tonidandel/scanner-linear/README.md

# scanner-linear
Repositório do projeto Scanner Linear de Livros, baseado em:
https://linearbookscanner.org/
