tonidandel/scanner-linear/projeto da Michigan-U/Wire_Diagram.pdf

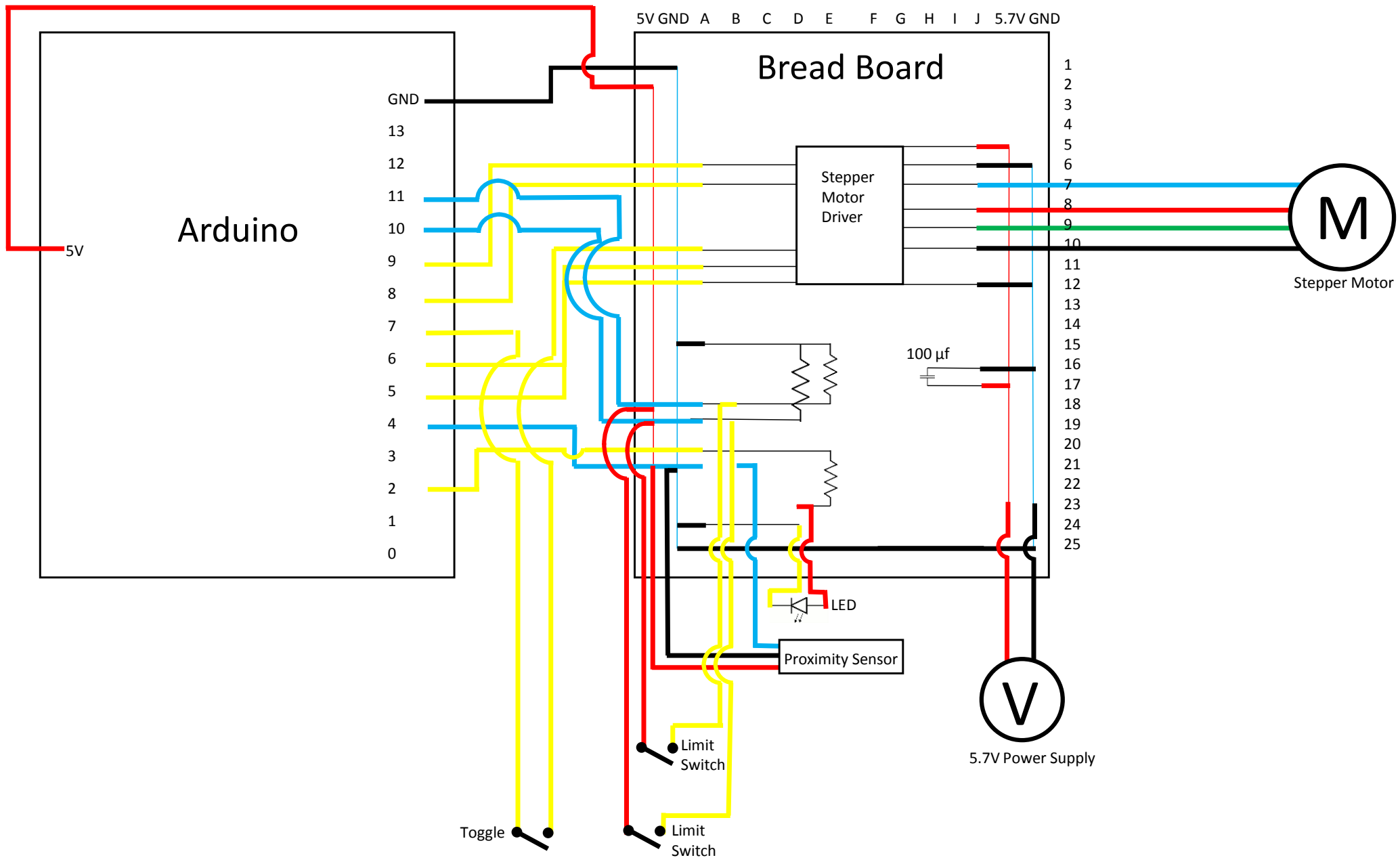
[picture p7: figure]
5V GND A; F G H I J 5.7V GND; GND; Arduino; Bread Board; 5.7V Power Supply; Proximity Sensor v; LED; Stepper Motor; Limit Switch; Toggle; Stepper Motor Driver
