tonidandel/scanner-linear/projeto da Michigan-U/LinearBookScannerCADW14/Follower Pulley Mounts/Follower Pulley Assembly.SLDASM

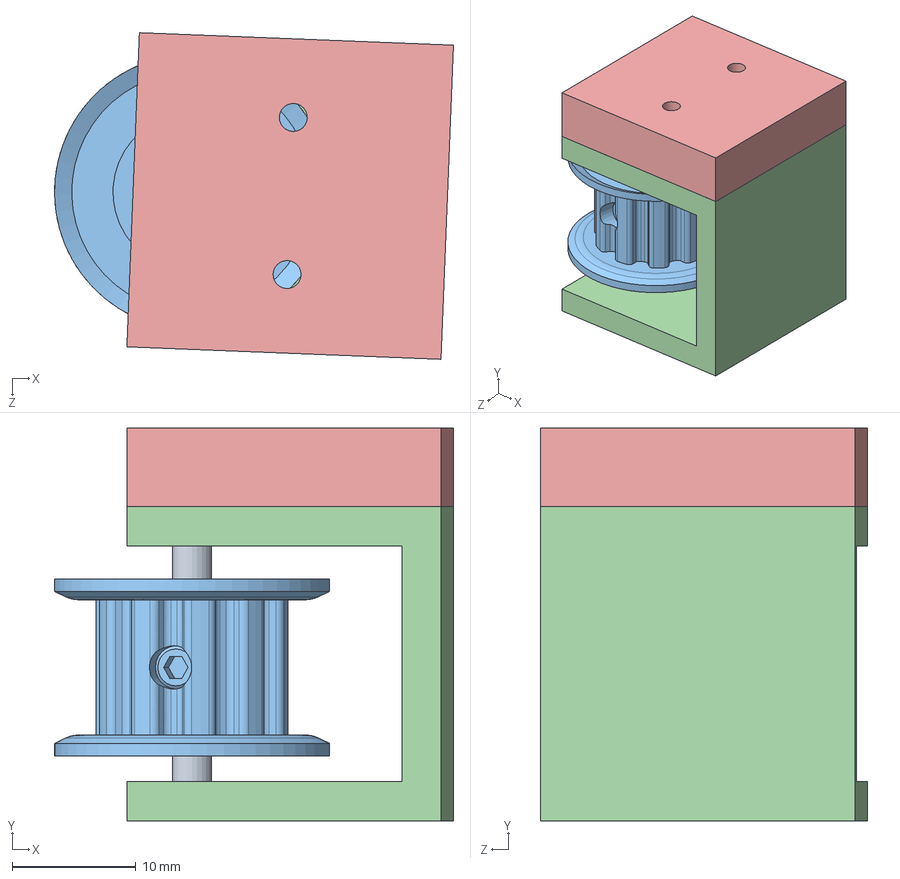
[picture p8: CAD file, 2019-04-22]
projeto da Michigan-U/LinearBookScannerCADW14/Follower Pulley Mounts/Follower Pulley Assembly.SLDASM
32.2 x 31.8 x 26.4 mm
Follower Pulley Shaft
Bushing
Follower Pulley
Follower Pulley Mount
Follower Spacer
