tonidandel/scanner-linear/projeto da Michigan-U/LinearBookScannerCADW14/Main Body/Linear Book Scanner.SLDASM

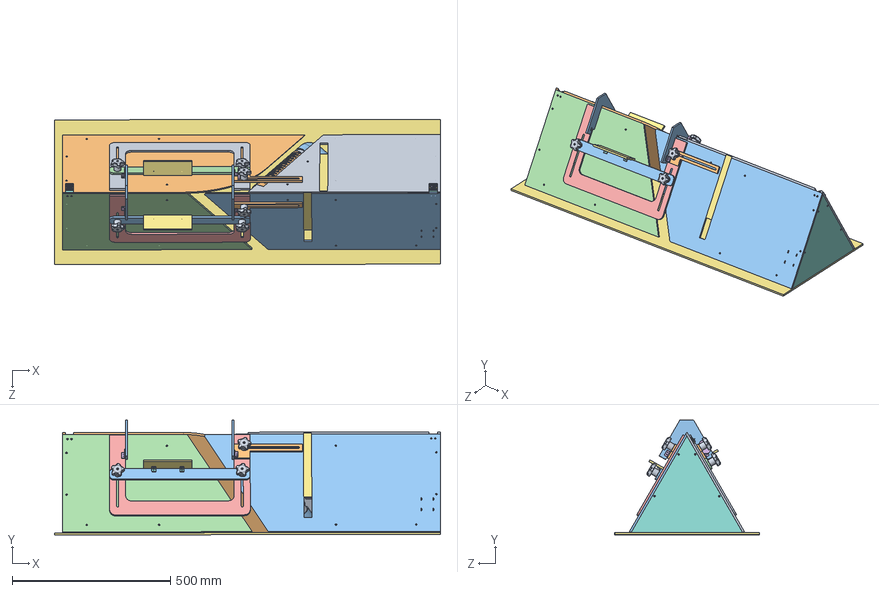
[picture p9: CAD file, 2019-04-22]
projeto da Michigan-U/LinearBookScannerCADW14/Main Body/Linear Book Scanner.SLDASM
1219.6 x 363.2 x 458.2 mm
Wall_1a
Wall_1b
Wall_2a
Wall_2b
90degBracket x 18
Brace_short x 4
Driven Pulley
Stepper Motor
Coupler
Bearing x 2
Motor Mount
Follower Pulley Shaft x 3
Bushing x 3
Follower Pulley x 3
Follower Pulley Mount x 3
Follower Spacer x 3
Inside Vacuum Tube
Outside Vacuum Tube
Elbow
Vacuum Plug
60degBracket x 8
Canon+220+Scanner+Bar x 2
GLASS+COVER%2C+SCANNER+BAR x 2
Bracket Vacuum Tube x 2
Side Intake
X Paddle Left Attachment
X Paddle Left 60 x 2
Cross Bar
Side Intake Back
X Paddle Bracket x 2
Y Paddle x 2
Standard Bracket x 4
59625K330 (1) x 6
X Paddle Left Attachment Back
Cross Bar Back
92210A546 x 6
91500A126 x 4
Tall X Paddle Bracket x 2
Base
Brace x 2
