tonidandel/scanner-linear/projeto da Michigan-U/LinearBookScannerCADW14/Vacuum/Vacuum Tube Assembly.SLDASM

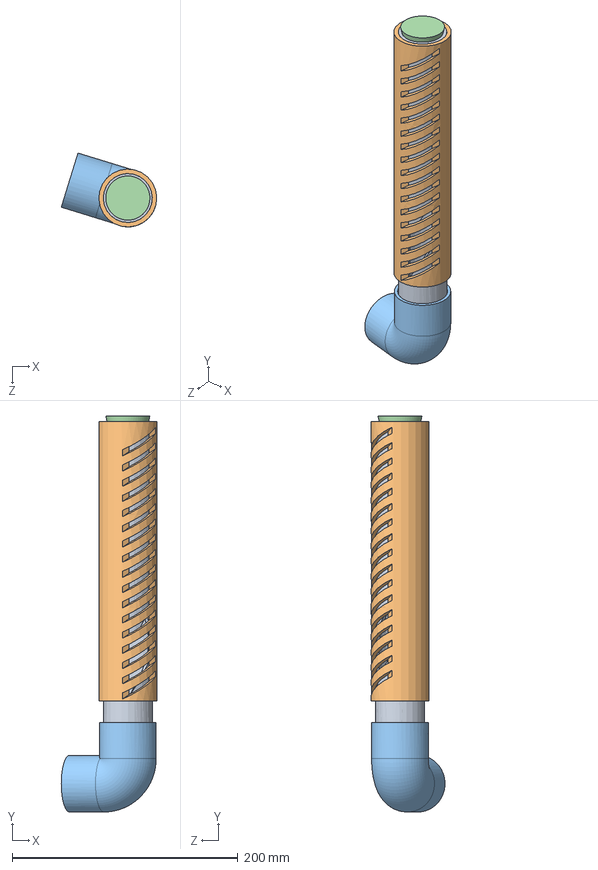
[picture p10: CAD file, 2019-04-22]
projeto da Michigan-U/LinearBookScannerCADW14/Vacuum/Vacuum Tube Assembly.SLDASM
84.6 x 350.9 x 65.5 mm
Inside Vacuum Tube
Outside Vacuum Tube
Elbow
Vacuum Plug
