tonidandel/scanner-linear/projeto da Michigan-U/LinearBookScannerCADW14/Scanner Bar/Scanner.SLDASM

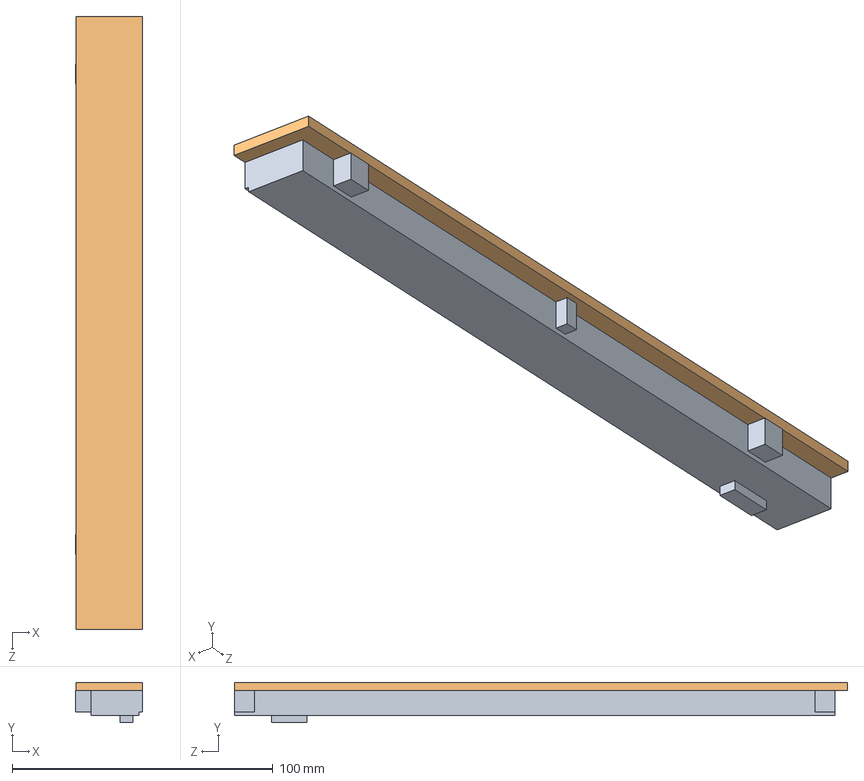
[picture p11: CAD file, 2019-04-22]
projeto da Michigan-U/LinearBookScannerCADW14/Scanner Bar/Scanner.SLDASM
25.5 x 15.5 x 235.0 mm
Canon+220+Scanner+Bar
GLASS+COVER%2C+SCANNER+BAR
