tonidandel/scanner-linear/projeto da Michigan-U/LinearBookScannerCADW14/Main Body/Large Brace Assm.SLDASM

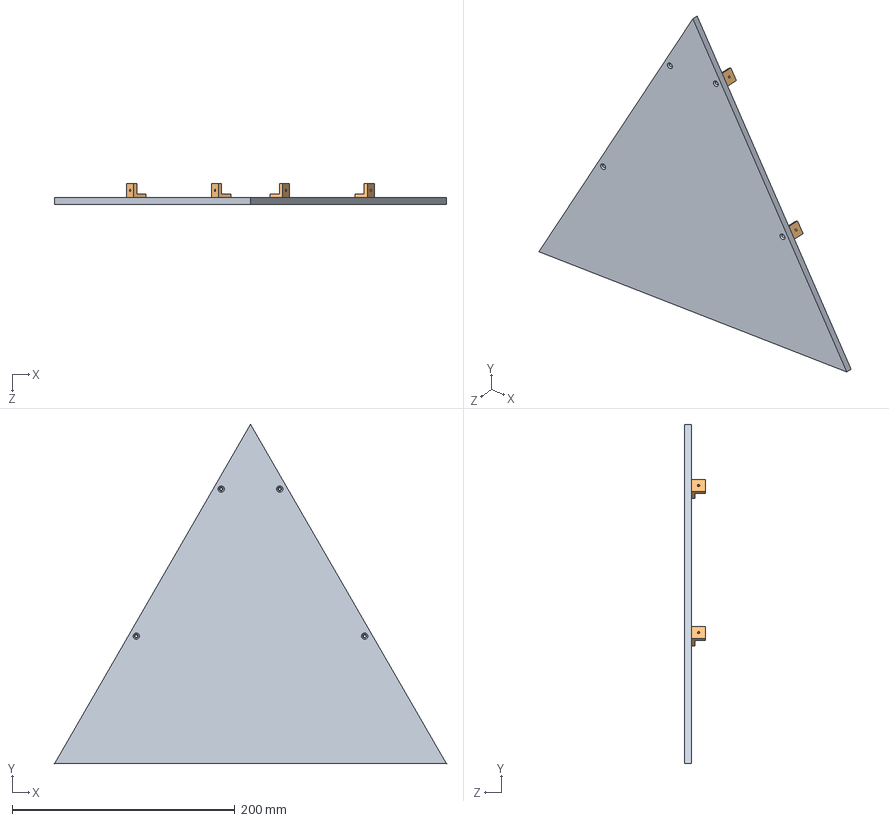
[picture p12: CAD file, 2019-04-22]
projeto da Michigan-U/LinearBookScannerCADW14/Main Body/Large Brace Assm.SLDASM
351.8 x 304.7 x 19.0 mm
Brace
90degBracket x 4
