tonidandel/scanner-linear/projeto da Michigan-U/LinearBookScannerCADW14/Vacuum/Vacuum Tube Bracket.SLDASM

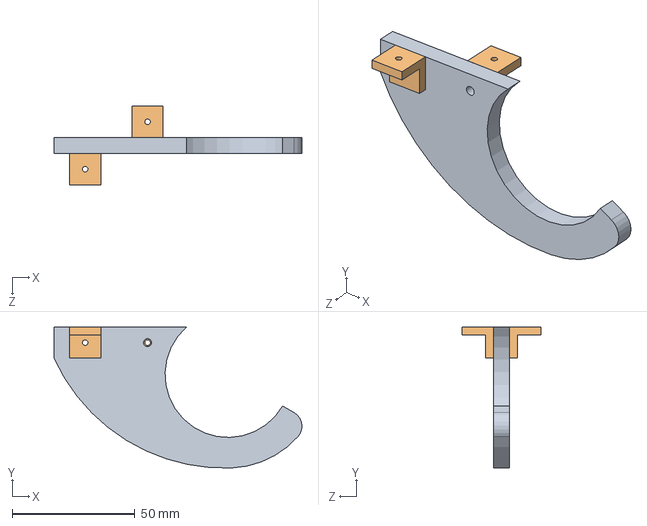
[picture p13: CAD file, 2019-04-22]
projeto da Michigan-U/LinearBookScannerCADW14/Vacuum/Vacuum Tube Bracket.SLDASM
101.0 x 57.4 x 32.0 mm
Bracket Vacuum Tube
90degBracket x 2
