tonidandel/scanner-linear/projeto da Michigan-U/LinearBookScannerCADW14/Main Body/Brace.SLDASM

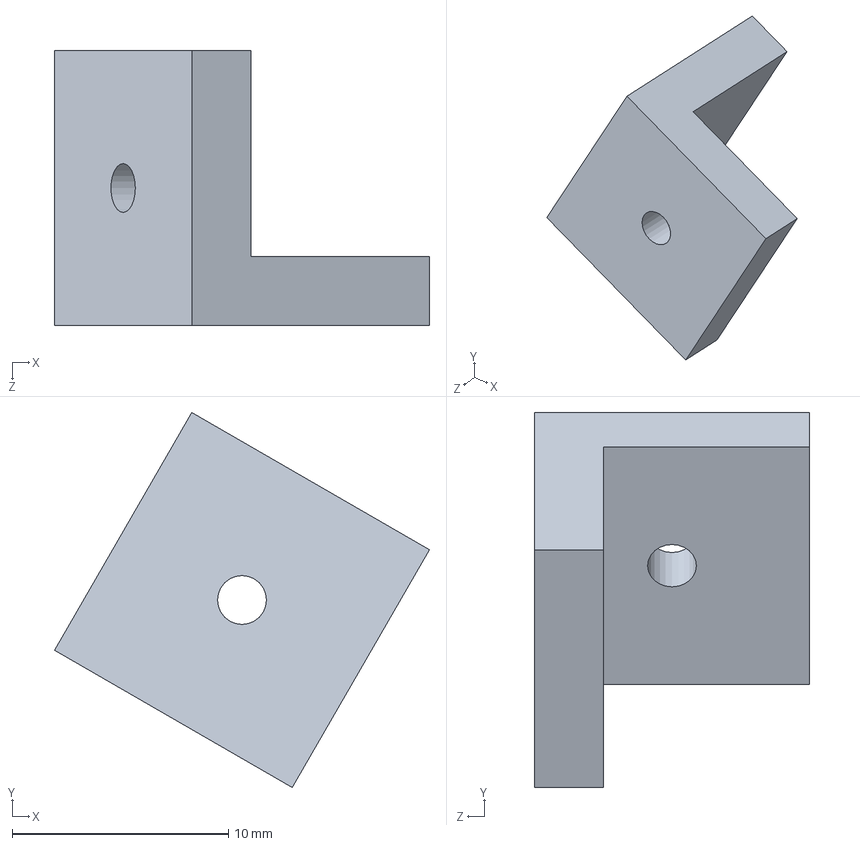
[picture p14: CAD file, 2019-04-22]
projeto da Michigan-U/LinearBookScannerCADW14/Main Body/Brace.SLDASM
17.3 x 17.3 x 12.7 mm
