tonidandel/scanner-linear/projeto da Michigan-U/LinearBookScannerCADW14/Motor/Motor Assembly v1/Motor Mount Assembly.SLDASM

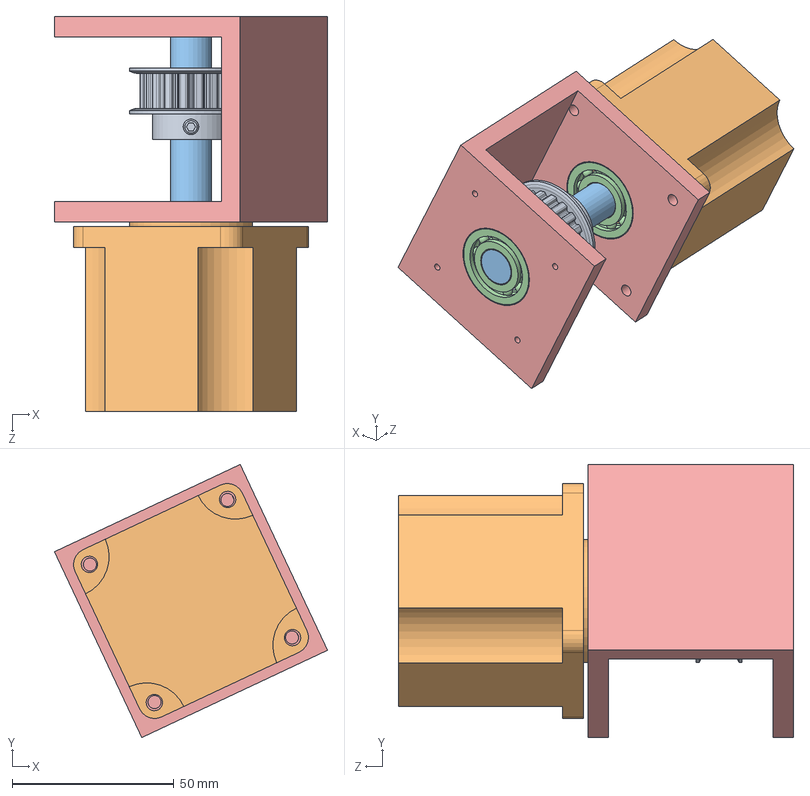
[picture p15: CAD file, 2019-04-22]
projeto da Michigan-U/LinearBookScannerCADW14/Motor/Motor Assembly v1/Motor Mount Assembly.SLDASM
84.5 x 84.5 x 122.2 mm
Driven Pulley
Stepper Motor
Coupler
Bearing x 2
Motor Mount
