tonidandel/scanner-linear/projeto da Michigan-U/LinearBookScannerCADW14/Saddle CAD v2/New Saddle CAD/Saddle Assembly.SLDASM

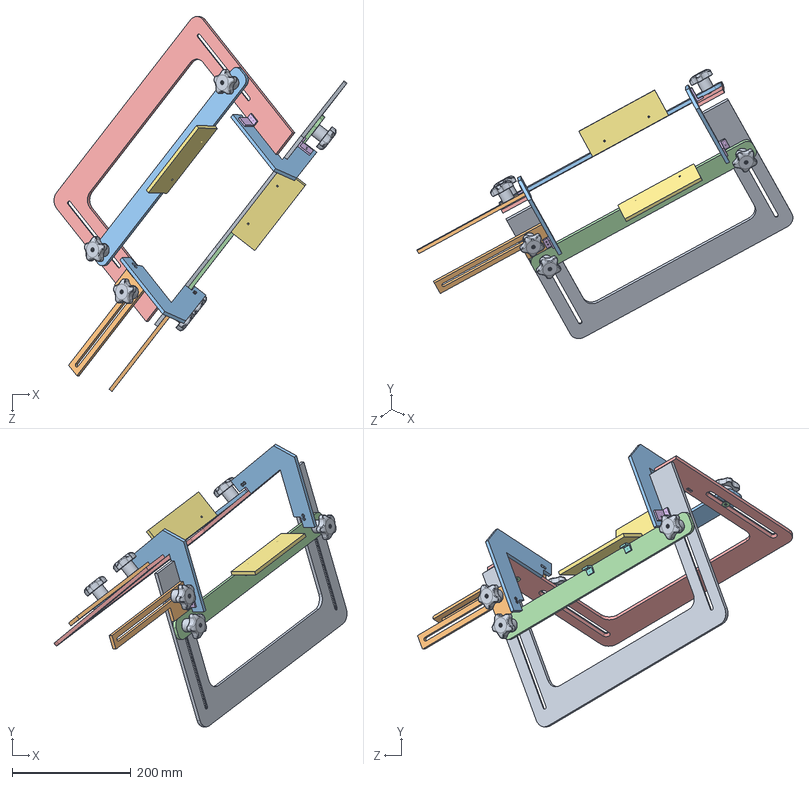
[picture p16: CAD file, 2019-04-22]
projeto da Michigan-U/LinearBookScannerCADW14/Saddle CAD v2/New Saddle CAD/Saddle Assembly.SLDASM
494.0 x 476.6 x 632.3 mm
Side Intake
X Paddle Left Attachment
X Paddle Left 60 x 2
Cross Bar
Side Intake Back
X Paddle Bracket x 2
Y Paddle x 2
Standard Bracket x 4
59625K330 (1) x 6
X Paddle Left Attachment Back
Cross Bar Back
92210A546 x 6
91500A126 x 4
Tall X Paddle Bracket x 2
