tonidandel/scanner-linear/projeto da Michigan-U/LinearBookScannerCADW14/Motor/Motor Assembly v1/Stepper Motor.SLDPRT

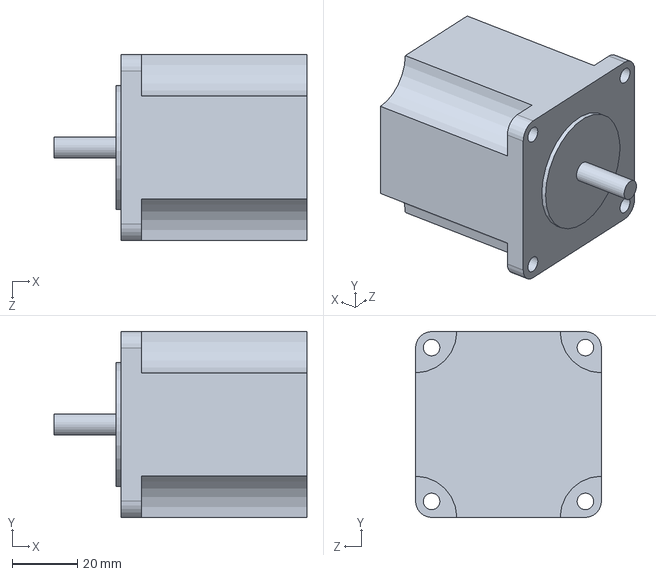
[picture p17: CAD file, 2019-04-22]
projeto da Michigan-U/LinearBookScannerCADW14/Motor/Motor Assembly v1/Stepper Motor.SLDPRT
77.7 x 57.1 x 57.1 mm
