tonidandel/scanner-linear/projeto da Michigan-U/LinearBookScannerCADW14/Saddle CAD v2/New Saddle CAD/Side Intake Back.SLDPRT

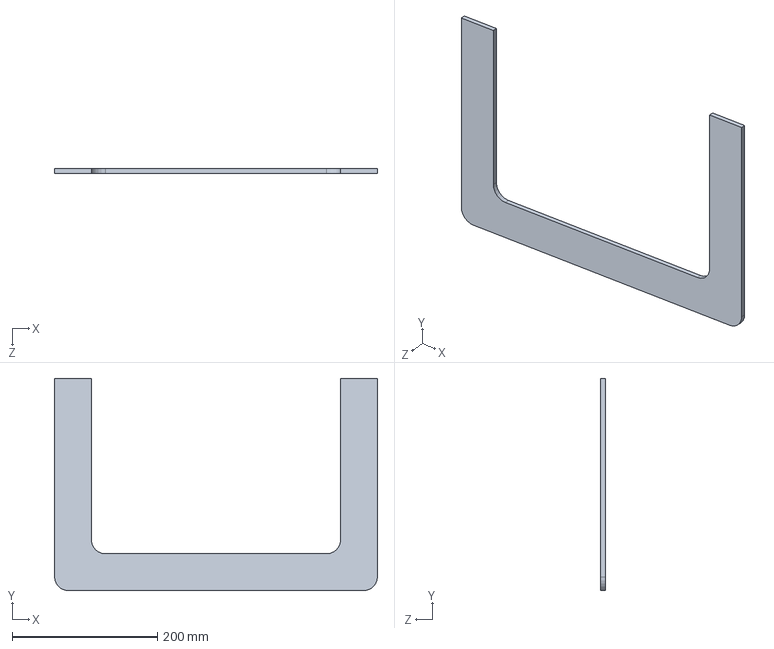
[picture p18: CAD file, 2019-04-22]
projeto da Michigan-U/LinearBookScannerCADW14/Saddle CAD v2/New Saddle CAD/Side Intake Back.SLDPRT
444.5 x 292.1 x 6.35 mm
