tonidandel/scanner-linear/projeto da Michigan-U/LinearBookScannerCADW14/Scanner Bar/GLASS+COVER%2C+SCANNER+BAR.SLDPRT

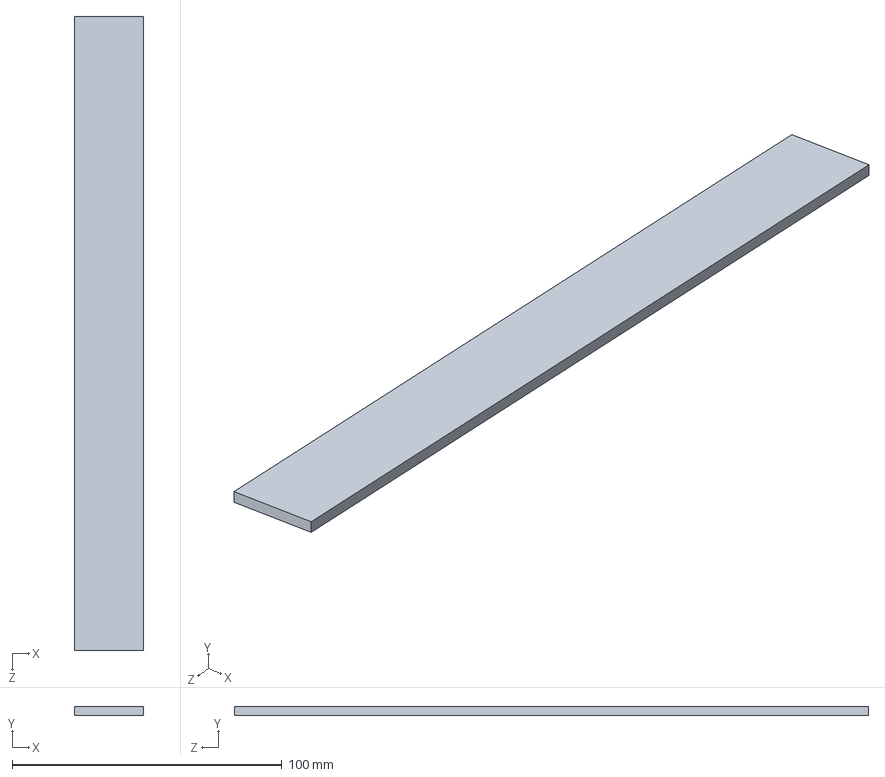
[picture p19: CAD file, 2019-04-22]
projeto da Michigan-U/LinearBookScannerCADW14/Scanner Bar/GLASS+COVER%2C+SCANNER+BAR.SLDPRT
25.4 x 3.17 x 235.0 mm
