tonidandel/scanner-linear/projeto da Michigan-U/LinearBookScannerCADW14/Follower Pulley Mounts/Bushing.SLDPRT

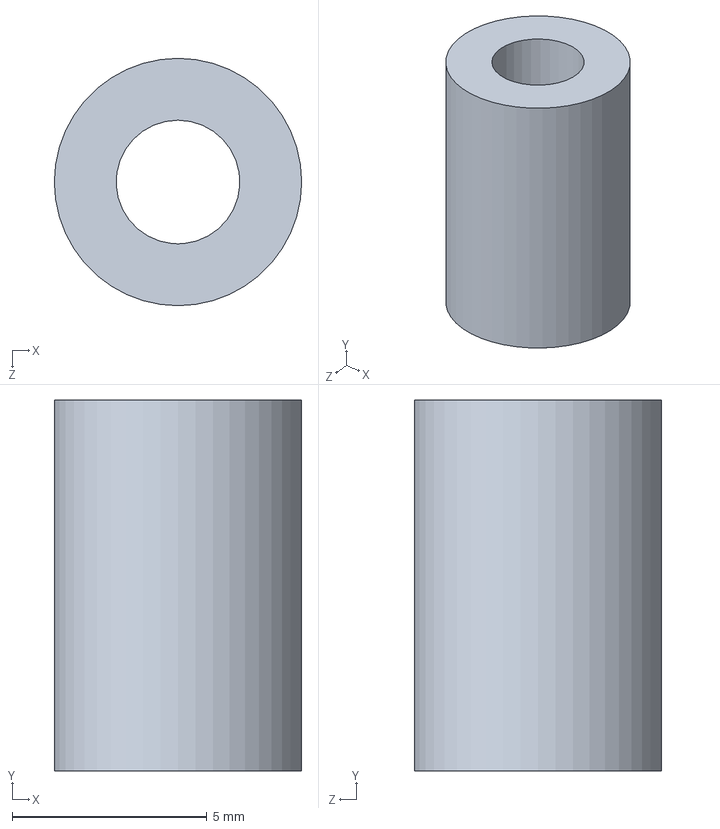
[picture p20: CAD file, 2019-04-22]
projeto da Michigan-U/LinearBookScannerCADW14/Follower Pulley Mounts/Bushing.SLDPRT
6.35 x 9.53 x 6.35 mm
