tonidandel/scanner-linear/projeto da Michigan-U/LinearBookScannerCADW14/Main Body/90degBracket.SLDPRT

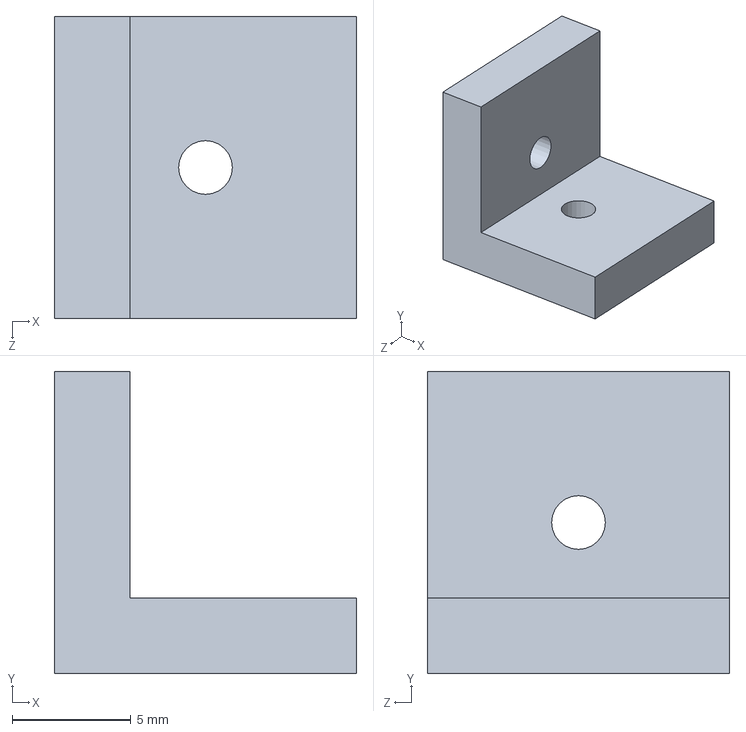
[picture p21: CAD file, 2019-04-22]
projeto da Michigan-U/LinearBookScannerCADW14/Main Body/90degBracket.SLDPRT
12.7 x 12.7 x 12.7 mm
