tonidandel/scanner-linear/projeto da Michigan-U/LinearBookScannerCADW14/Motor/Motor Assembly v1/Coupler.SLDPRT

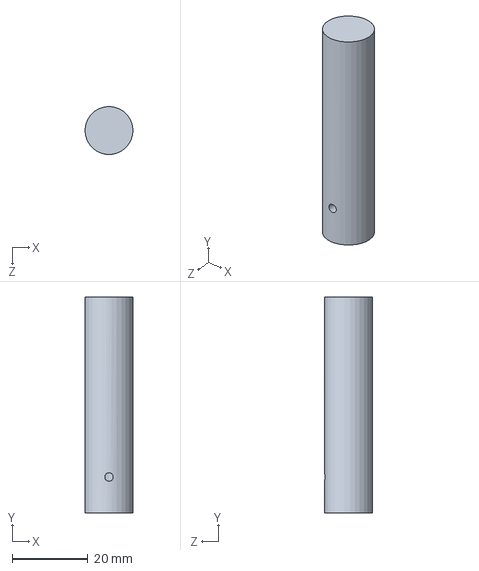
[picture p22: CAD file, 2019-04-22]
projeto da Michigan-U/LinearBookScannerCADW14/Motor/Motor Assembly v1/Coupler.SLDPRT
12.7 x 57.1 x 12.7 mm
