tonidandel/scanner-linear/projeto da Michigan-U/LinearBookScannerCADW14/Saddle CAD v2/New Saddle CAD/X Paddle Bracket.SLDPRT

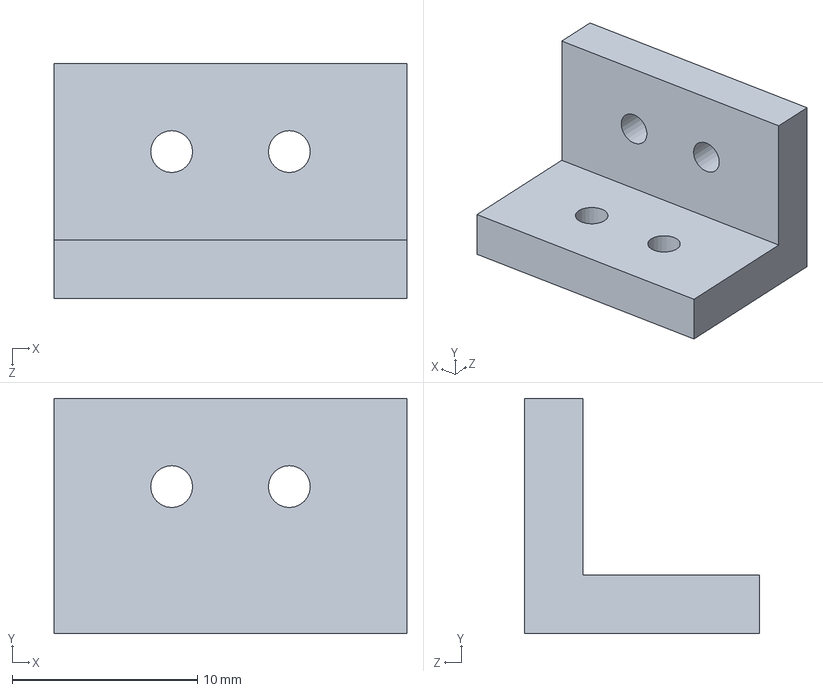
[picture p23: CAD file, 2019-04-22]
projeto da Michigan-U/LinearBookScannerCADW14/Saddle CAD v2/New Saddle CAD/X Paddle Bracket.SLDPRT
19.1 x 12.7 x 12.7 mm
