tonidandel/scanner-linear/projeto da Michigan-U/LinearBookScannerCADW14/Vacuum/Elbow.SLDPRT

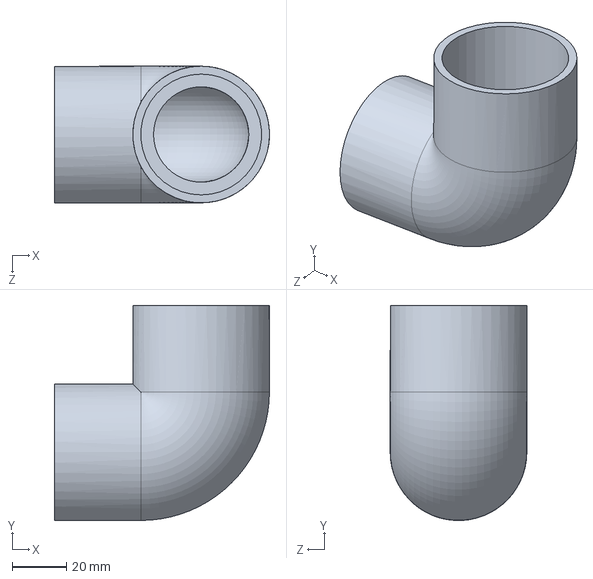
[picture p24: CAD file, 2019-04-22]
projeto da Michigan-U/LinearBookScannerCADW14/Vacuum/Elbow.SLDPRT
79.1 x 79.1 x 50.3 mm
