tonidandel/scanner-linear/projeto da Michigan-U/LinearBookScannerCADW14/Follower Pulley Mounts/Follower Pulley.SLDPRT

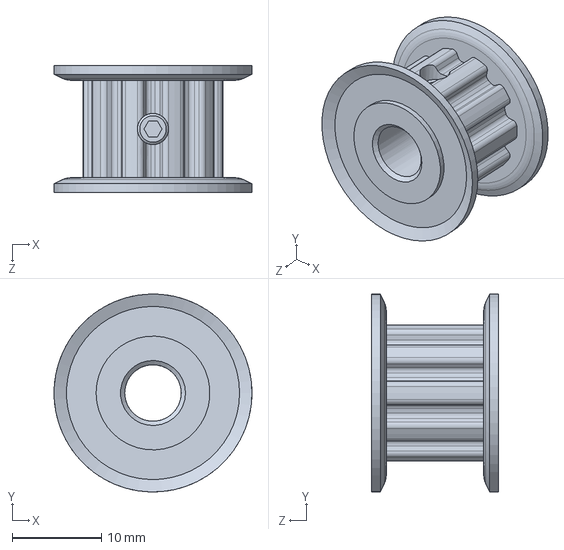
[picture p25: CAD file, 2019-04-22]
projeto da Michigan-U/LinearBookScannerCADW14/Follower Pulley Mounts/Follower Pulley.SLDPRT
22.2 x 22.2 x 14.3 mm
