tonidandel/scanner-linear/projeto da Michigan-U/LinearBookScannerCADW14/Main Body/Brace_short.SLDPRT

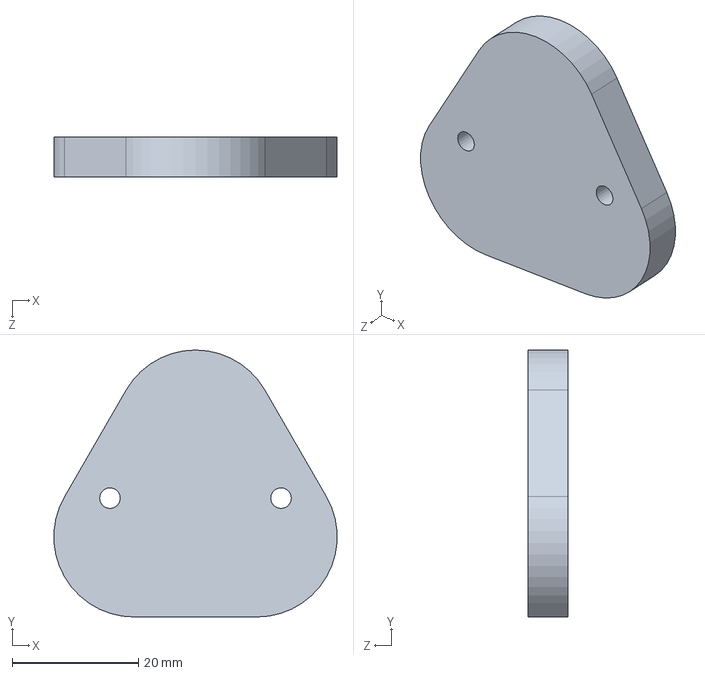
[picture p26: CAD file, 2019-04-22]
projeto da Michigan-U/LinearBookScannerCADW14/Main Body/Brace_short.SLDPRT
44.8 x 42.3 x 6.35 mm
