tonidandel/scanner-linear/projeto da Michigan-U/LinearBookScannerCADW14/Motor/Motor Assembly v1/Driven Pulley.SLDPRT

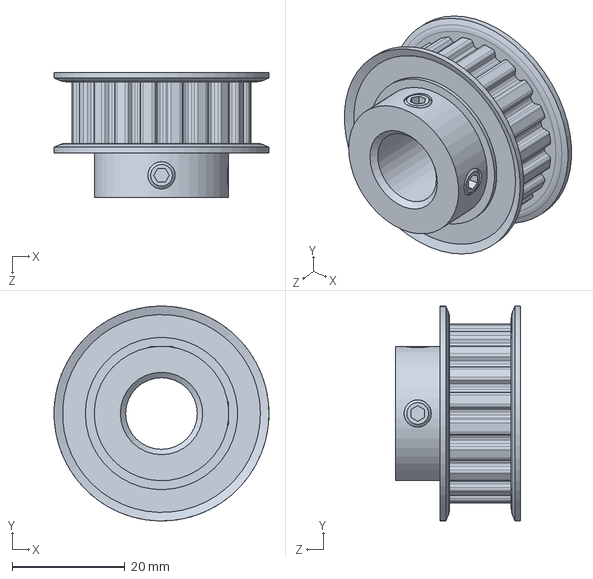
[picture p27: CAD file, 2019-04-22]
projeto da Michigan-U/LinearBookScannerCADW14/Motor/Motor Assembly v1/Driven Pulley.SLDPRT
38.1 x 38.1 x 22.2 mm
