tonidandel/scanner-linear/projeto da Michigan-U/LinearBookScannerCADW14/Saddle CAD v2/New Saddle CAD/Y Paddle.SLDPRT

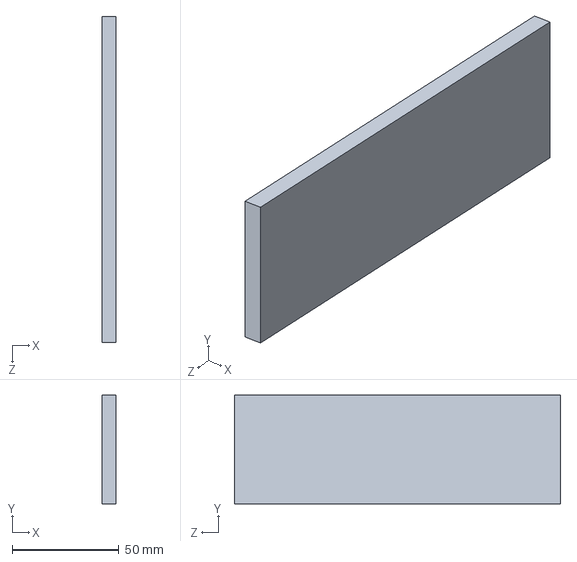
[picture p28: CAD file, 2019-04-22]
projeto da Michigan-U/LinearBookScannerCADW14/Saddle CAD v2/New Saddle CAD/Y Paddle.SLDPRT
6.35 x 50.8 x 152.4 mm
