tonidandel/scanner-linear/projeto da Michigan-U/LinearBookScannerCADW14/Scanner Bar/Canon+220+Scanner+Bar.SLDPRT

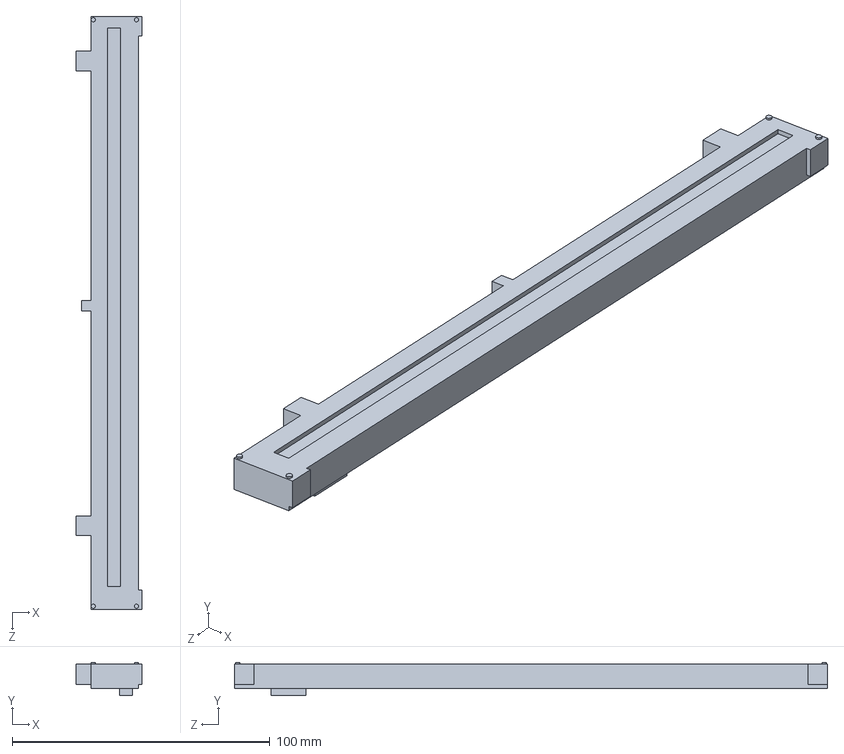
[picture p29: CAD file, 2019-04-22]
projeto da Michigan-U/LinearBookScannerCADW14/Scanner Bar/Canon+220+Scanner+Bar.SLDPRT
25.5 x 12.8 x 230.2 mm
