tonidandel/scanner-linear/projeto da Michigan-U/LinearBookScannerCADW14/Vacuum/Outside Vacuum Tube.SLDPRT

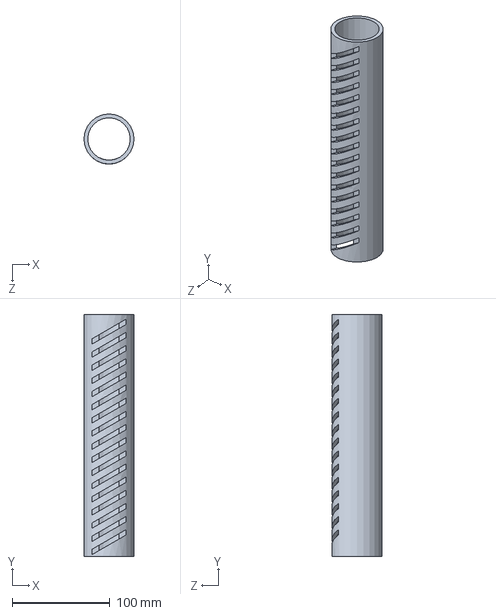
[picture p30: CAD file, 2019-04-22]
projeto da Michigan-U/LinearBookScannerCADW14/Vacuum/Outside Vacuum Tube.SLDPRT
51.3 x 247.6 x 51.3 mm
