tonidandel/scanner-linear/projeto da Michigan-U/LinearBookScannerCADW14/Follower Pulley Mounts/Follower Pulley Shaft.SLDPRT

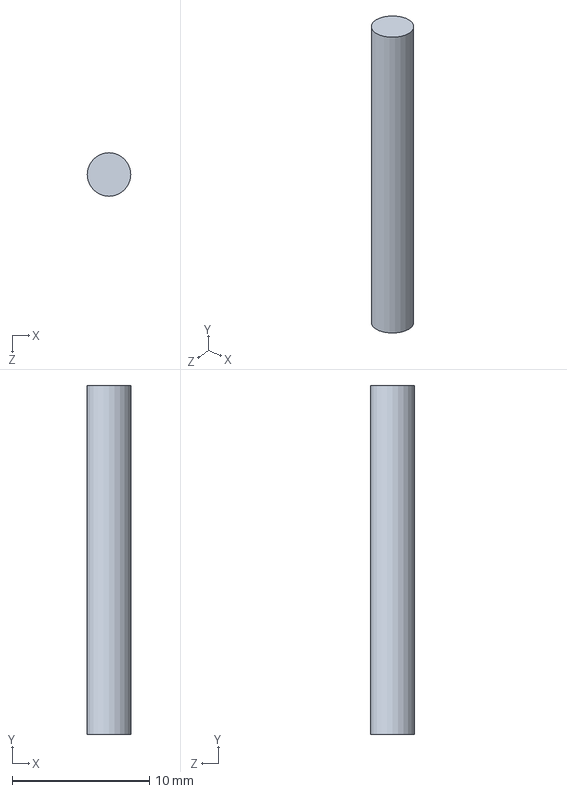
[picture p31: CAD file, 2019-04-22]
projeto da Michigan-U/LinearBookScannerCADW14/Follower Pulley Mounts/Follower Pulley Shaft.SLDPRT
3.17 x 25.4 x 3.17 mm
