tonidandel/scanner-linear/projeto da Michigan-U/LinearBookScannerCADW14/Motor/Motor Assembly v1/Motor Mount.SLDPRT

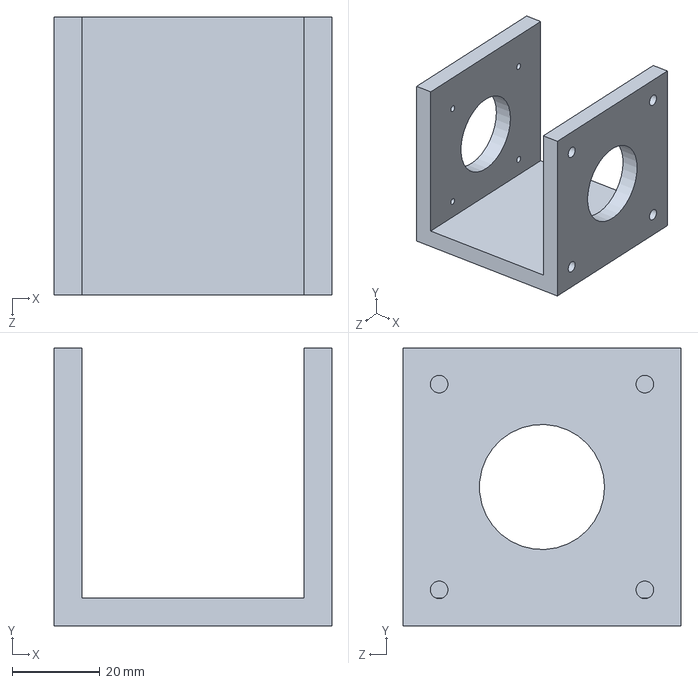
[picture p32: CAD file, 2019-04-22]
projeto da Michigan-U/LinearBookScannerCADW14/Motor/Motor Assembly v1/Motor Mount.SLDPRT
63.5 x 63.5 x 63.5 mm
