tonidandel/scanner-linear/projeto da Michigan-U/LinearBookScannerCADW14/Saddle CAD v2/New Saddle CAD/Top Angle Bracket.SLDPRT

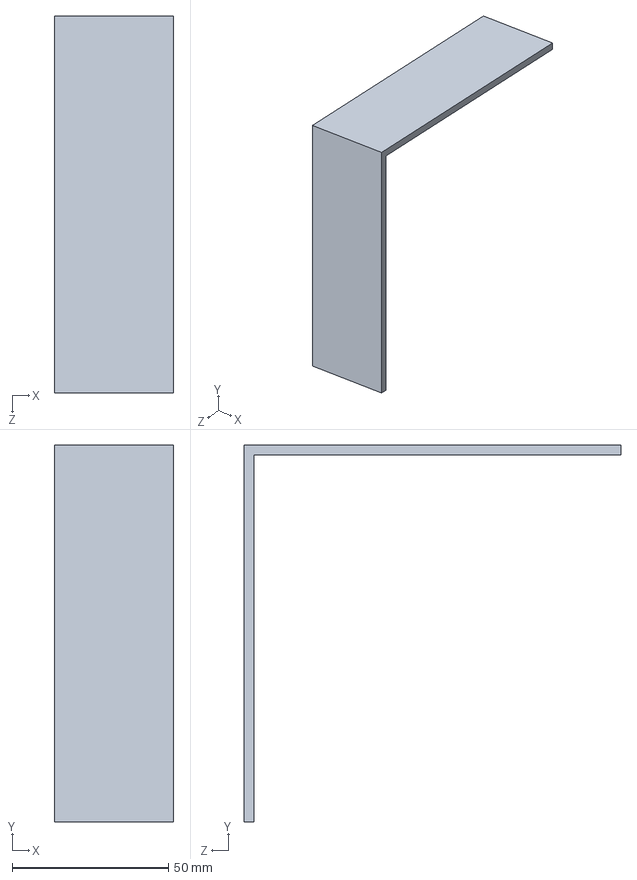
[picture p33: CAD file, 2019-04-22]
projeto da Michigan-U/LinearBookScannerCADW14/Saddle CAD v2/New Saddle CAD/Top Angle Bracket.SLDPRT
38.1 x 120.7 x 120.7 mm
