tonidandel/scanner-linear/projeto da Michigan-U/LinearBookScannerCADW14/Vacuum/Inside Vacuum Tube.SLDPRT

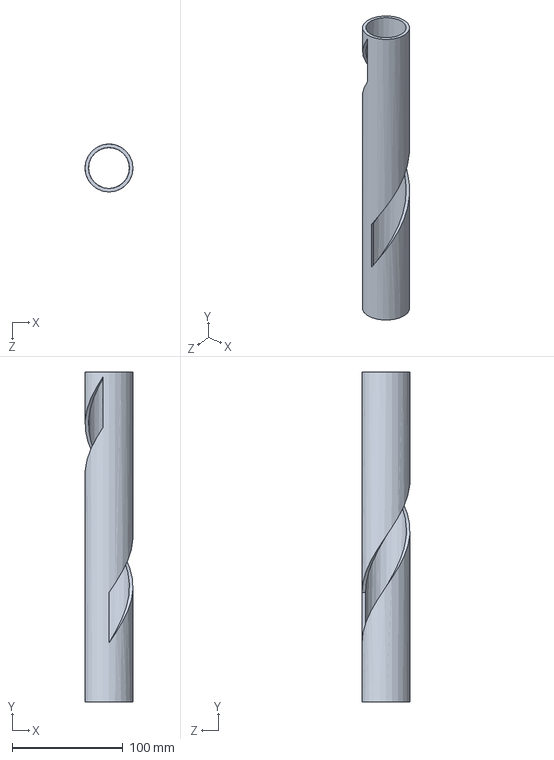
[picture p34: CAD file, 2019-04-22]
projeto da Michigan-U/LinearBookScannerCADW14/Vacuum/Inside Vacuum Tube.SLDPRT
43.4 x 298.5 x 43.4 mm
