tonidandel/scanner-linear/projeto da Michigan-U/LinearBookScannerCADW14/Follower Pulley Mounts/Follower Spacer.SLDPRT

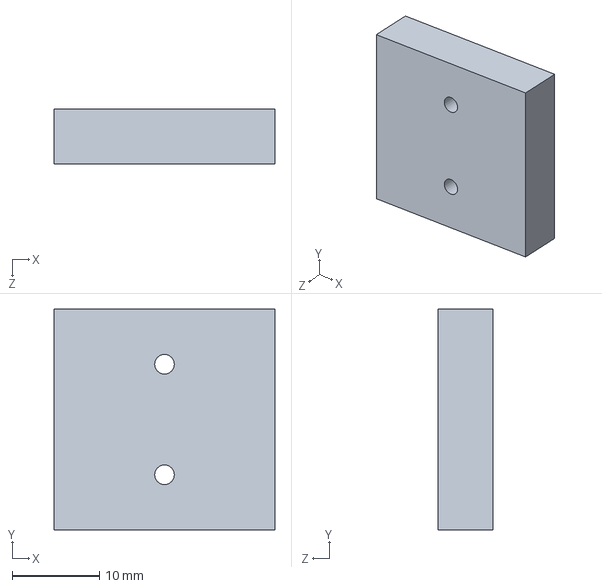
[picture p35: CAD file, 2019-04-22]
projeto da Michigan-U/LinearBookScannerCADW14/Follower Pulley Mounts/Follower Spacer.SLDPRT
25.4 x 25.4 x 6.35 mm
