tonidandel/scanner-linear/projeto da Michigan-U/LinearBookScannerCADW14/Main Body/Base.SLDPRT

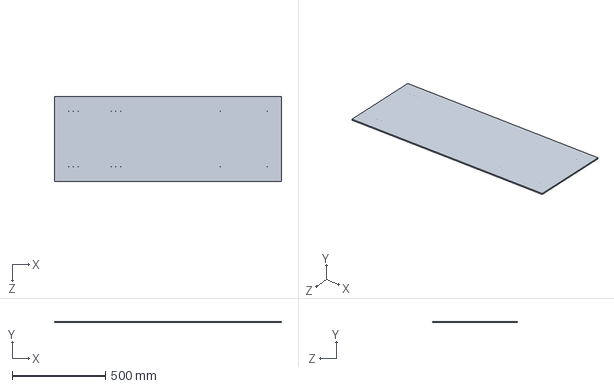
[picture p36: CAD file, 2019-04-22]
projeto da Michigan-U/LinearBookScannerCADW14/Main Body/Base.SLDPRT
1219.2 x 6.35 x 457.2 mm
