tonidandel/scanner-linear/projeto da Michigan-U/LinearBookScannerCADW14/Motor/Motor Assembly v1/Bearing.SLDPRT

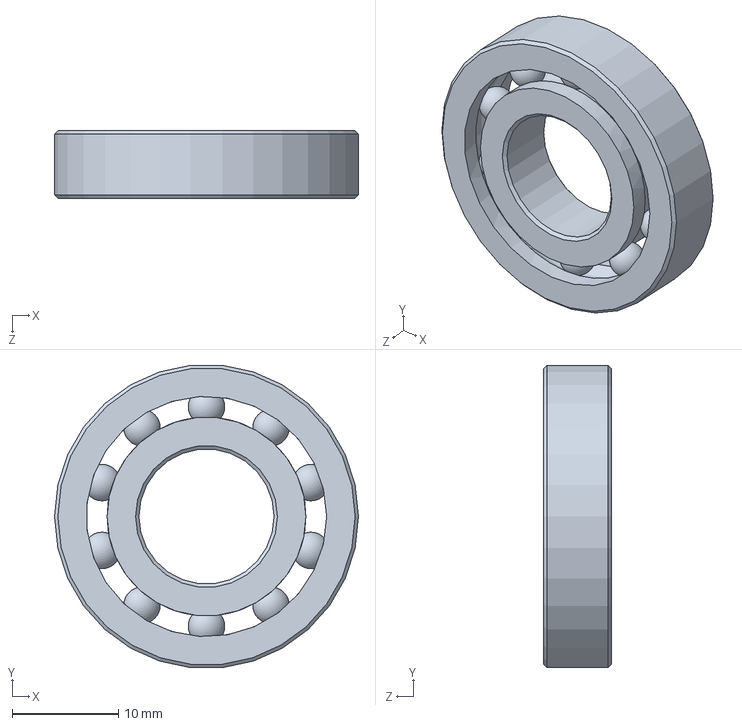
[picture p37: CAD file, 2019-04-22]
projeto da Michigan-U/LinearBookScannerCADW14/Motor/Motor Assembly v1/Bearing.SLDPRT
28.6 x 28.4 x 6.35 mm
