tonidandel/scanner-linear/projeto da Michigan-U/LinearBookScannerCADW14/Saddle CAD v2/New Saddle CAD/X Paddle Left Attachment Back.SLDPRT

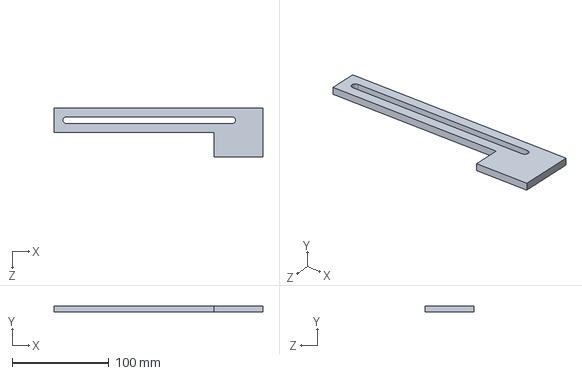
[picture p38: CAD file, 2019-04-22]
projeto da Michigan-U/LinearBookScannerCADW14/Saddle CAD v2/New Saddle CAD/X Paddle Left Attachment Back.SLDPRT
215.9 x 6.35 x 50.8 mm
