tonidandel/scanner-linear/projeto da Michigan-U/LinearBookScannerCADW14/Follower Pulley Mounts/Follower Pulley Mount.SLDPRT

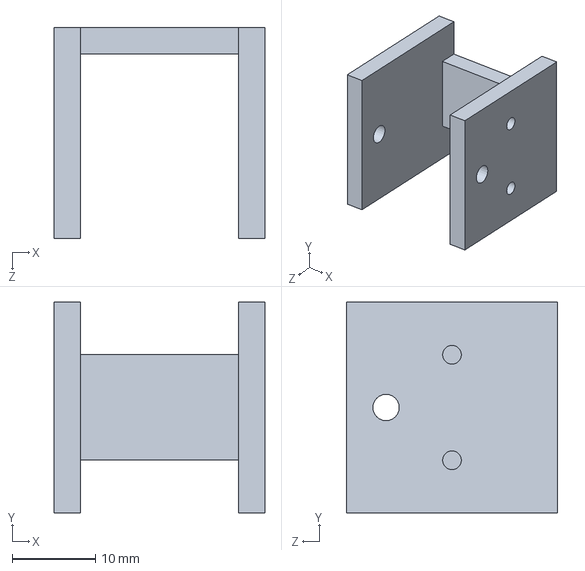
[picture p39: CAD file, 2019-04-22]
projeto da Michigan-U/LinearBookScannerCADW14/Follower Pulley Mounts/Follower Pulley Mount.SLDPRT
25.4 x 25.4 x 25.4 mm
