tonidandel/scanner-linear/projeto da Michigan-U/LinearBookScannerCADW14/Main Body/Wall_2a.SLDPRT

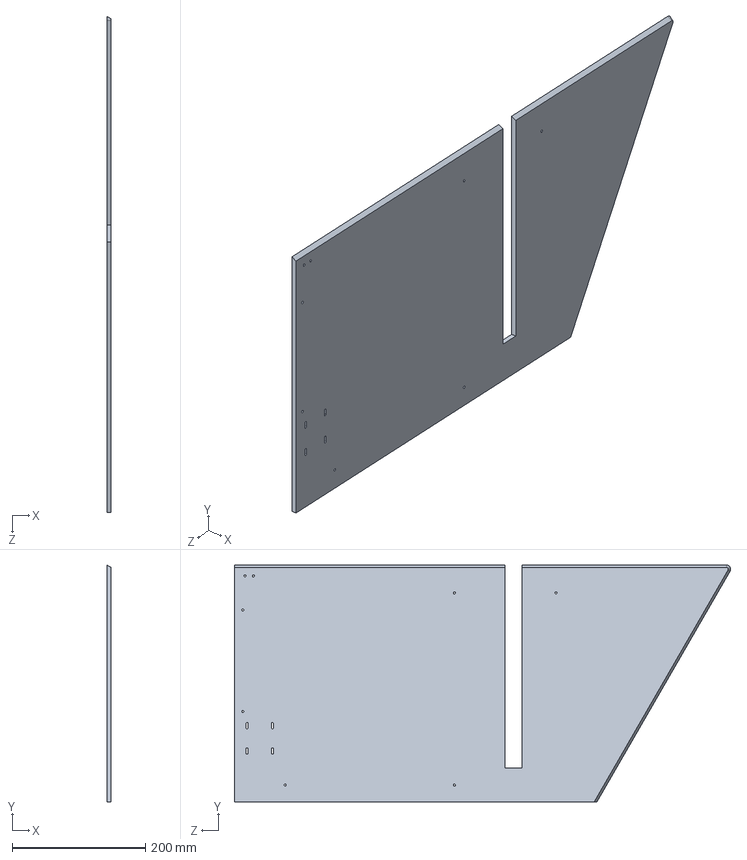
[picture p40: CAD file, 2019-04-22]
projeto da Michigan-U/LinearBookScannerCADW14/Main Body/Wall_2a.SLDPRT
6.35 x 355.6 x 744.7 mm
