tonidandel/scanner-linear/projeto da Michigan-U/LinearBookScannerCADW14/Vacuum/Bracket Vacuum Tube.SLDPRT

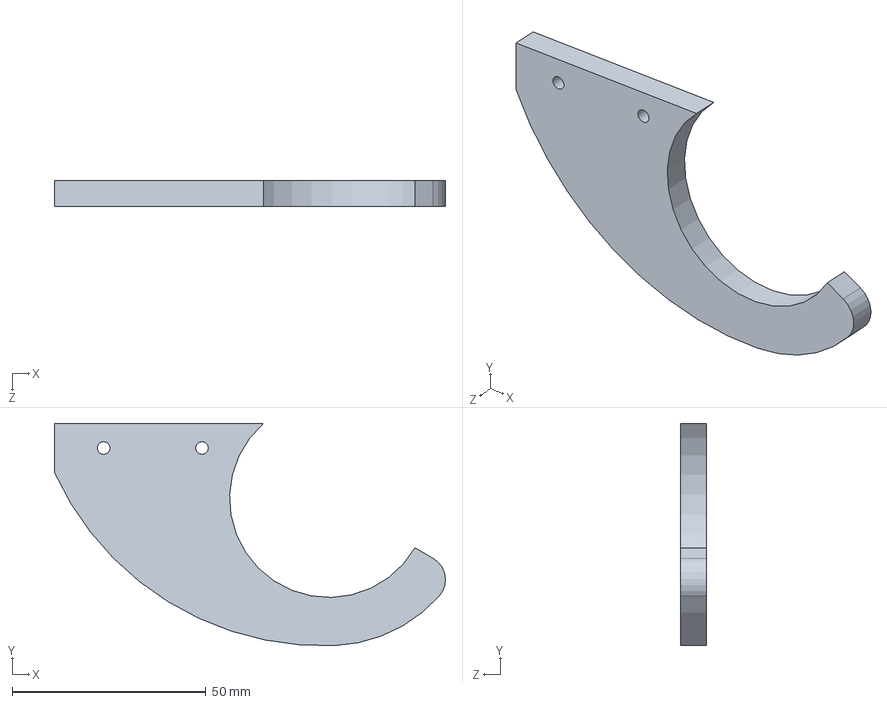
[picture p41: CAD file, 2019-04-22]
projeto da Michigan-U/LinearBookScannerCADW14/Vacuum/Bracket Vacuum Tube.SLDPRT
101.0 x 57.4 x 6.60 mm
