tonidandel/scanner-linear/projeto da Michigan-U/LinearBookScannerCADW14/Vacuum/Vacuum Plug.SLDPRT

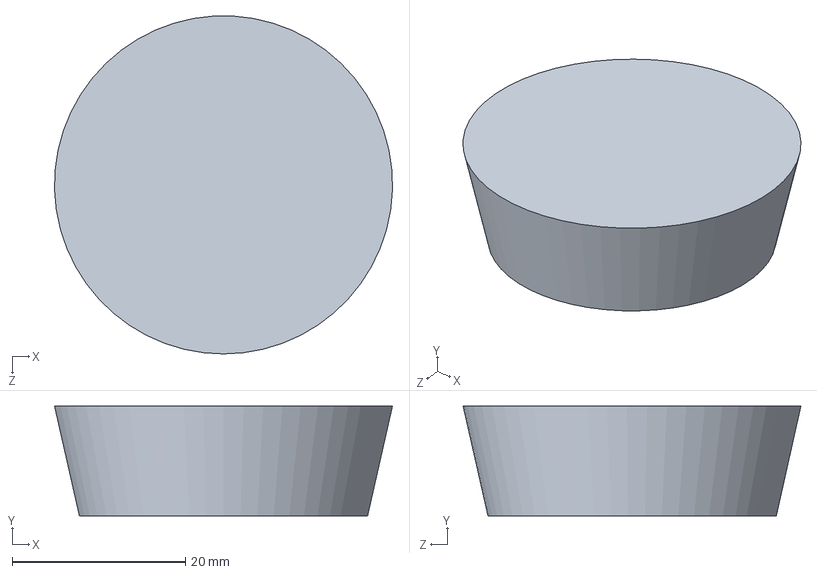
[picture p42: CAD file, 2019-04-22]
projeto da Michigan-U/LinearBookScannerCADW14/Vacuum/Vacuum Plug.SLDPRT
39.1 x 12.7 x 39.1 mm
