tonidandel/scanner-linear/projeto da Michigan-U/LinearBookScannerCADW14/Main Body/Wall_1b.SLDPRT

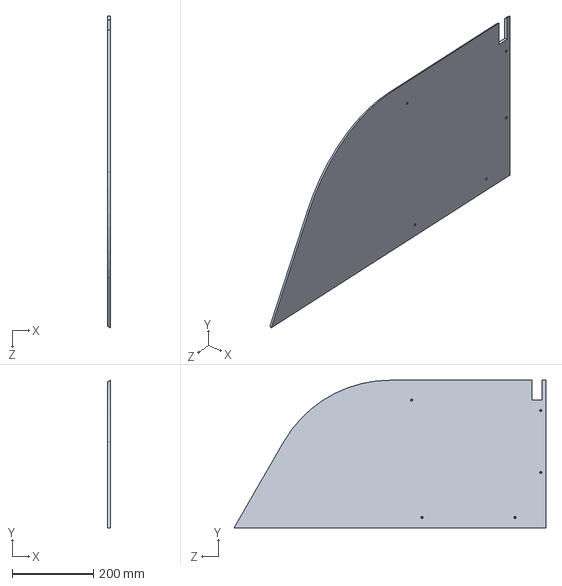
[picture p43: CAD file, 2019-04-22]
projeto da Michigan-U/LinearBookScannerCADW14/Main Body/Wall_1b.SLDPRT
6.35 x 362.7 x 766.8 mm
