tonidandel/scanner-linear/projeto da Michigan-U/LinearBookScannerCADW14/Saddle CAD v2/New Saddle CAD/X Paddle Left.SLDPRT

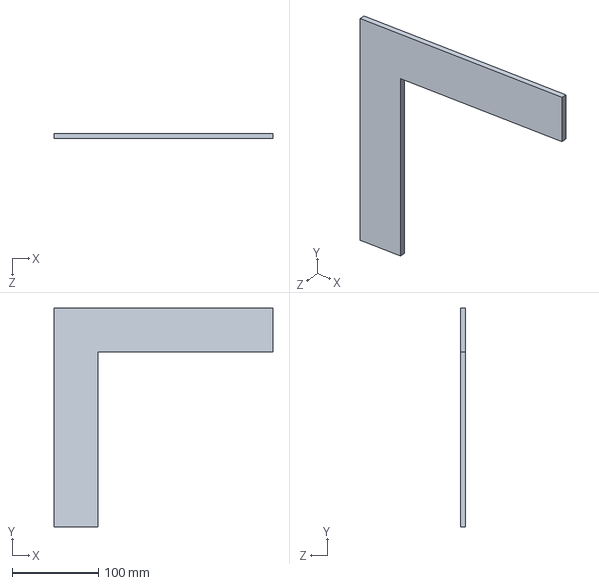
[picture p44: CAD file, 2019-04-22]
projeto da Michigan-U/LinearBookScannerCADW14/Saddle CAD v2/New Saddle CAD/X Paddle Left.SLDPRT
254.0 x 254.0 x 6.35 mm
