tonidandel/scanner-linear/projeto da Michigan-U/LinearBookScannerCADW14/Main Body/60degBracket.SLDPRT

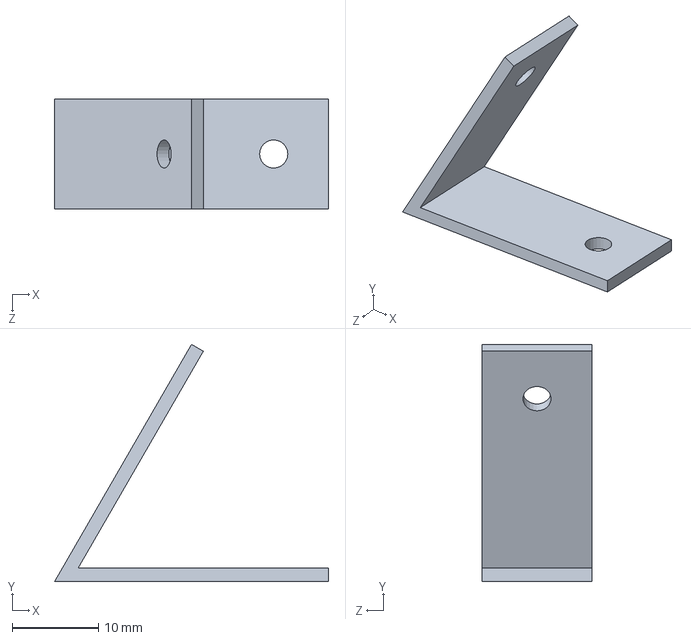
[picture p45: CAD file, 2019-04-22]
projeto da Michigan-U/LinearBookScannerCADW14/Main Body/60degBracket.SLDPRT
31.8 x 27.5 x 12.7 mm
