tonidandel/scanner-linear/projeto da Michigan-U/LinearBookScannerCADW14/Saddle CAD v2/New Saddle CAD/X Paddle Left 60.SLDPRT

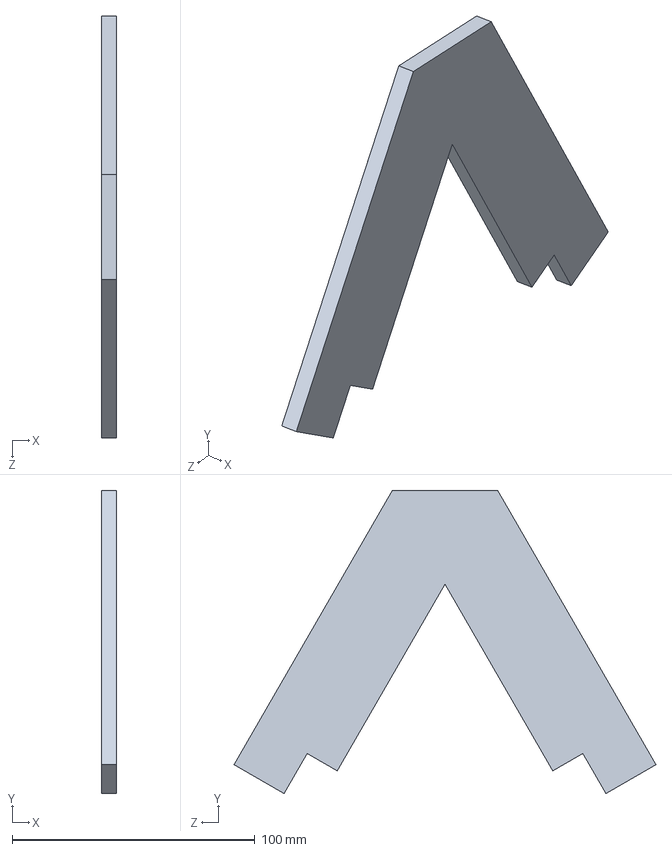
[picture p46: CAD file, 2019-04-22]
projeto da Michigan-U/LinearBookScannerCADW14/Saddle CAD v2/New Saddle CAD/X Paddle Left 60.SLDPRT
6.35 x 124.8 x 173.8 mm
