tonidandel/scanner-linear/projeto da Michigan-U/LinearBookScannerCADW14/Main Body/Wall_1a.SLDPRT

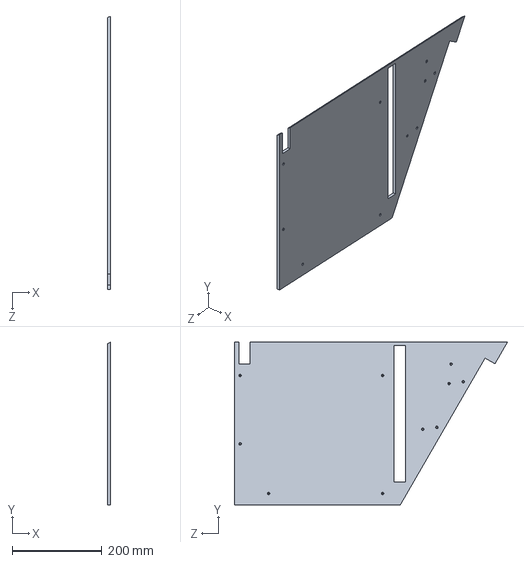
[picture p47: CAD file, 2019-04-22]
projeto da Michigan-U/LinearBookScannerCADW14/Main Body/Wall_1a.SLDPRT
6.35 x 362.7 x 608.2 mm
