tonidandel/scanner-linear/projeto da Michigan-U/LinearBookScannerCADW14/Main Body/PulleyBracket.SLDPRT

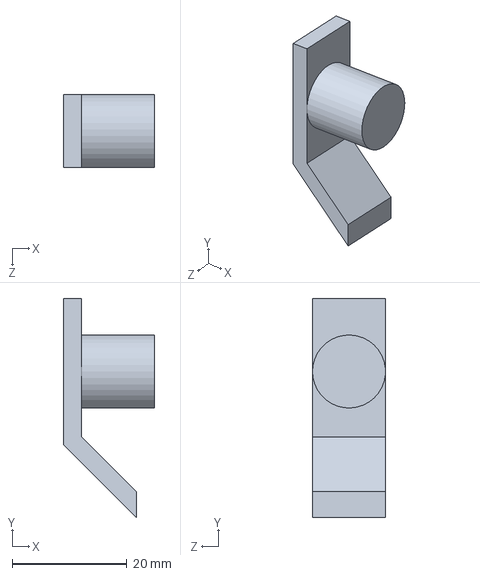
[picture p48: CAD file, 2019-04-22]
projeto da Michigan-U/LinearBookScannerCADW14/Main Body/PulleyBracket.SLDPRT
15.9 x 38.1 x 12.7 mm
