tonidandel/scanner-linear/projeto da Michigan-U/LinearBookScannerCADW14/Main Body/Wall_2b.SLDPRT

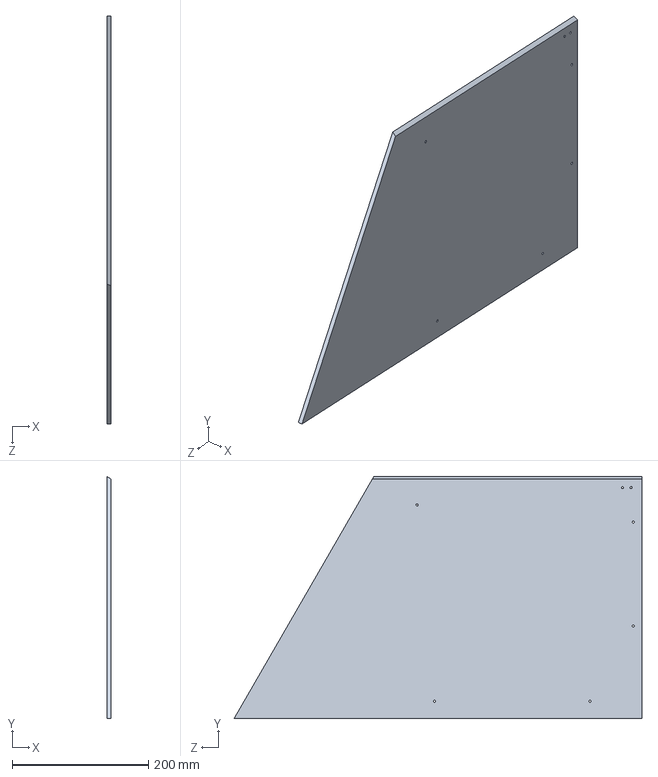
[picture p49: CAD file, 2019-04-22]
projeto da Michigan-U/LinearBookScannerCADW14/Main Body/Wall_2b.SLDPRT
6.35 x 355.4 x 599.0 mm
