tonidandel/scanner-linear/projeto da Michigan-U/LinearBookScannerCADW14/Saddle CAD v2/New Saddle CAD/Stock Top Angle Bracket.SLDPRT

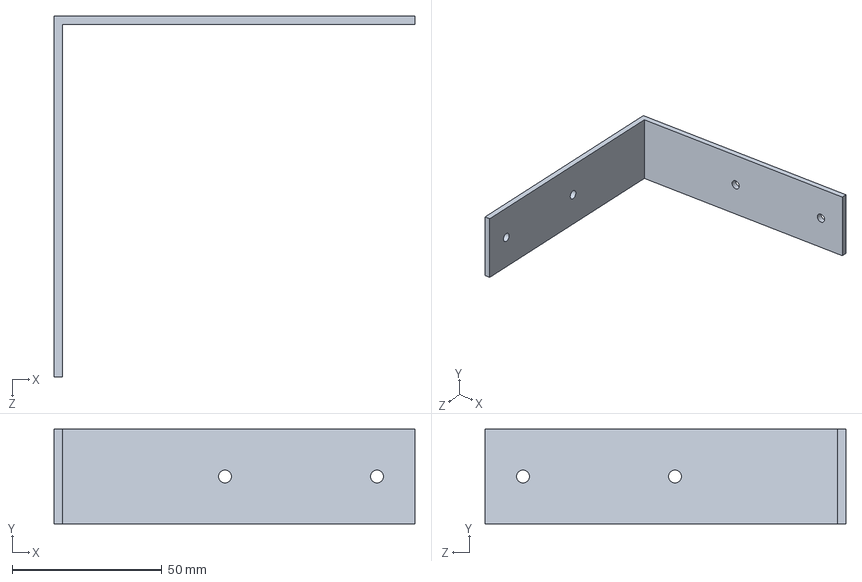
[picture p50: CAD file, 2019-04-22]
projeto da Michigan-U/LinearBookScannerCADW14/Saddle CAD v2/New Saddle CAD/Stock Top Angle Bracket.SLDPRT
120.7 x 31.8 x 120.7 mm
