tonidandel/scanner-linear/projeto da Michigan-U/LinearBookScannerCADW14/Saddle CAD v2/New Saddle CAD/60 Degree Bracket.SLDPRT

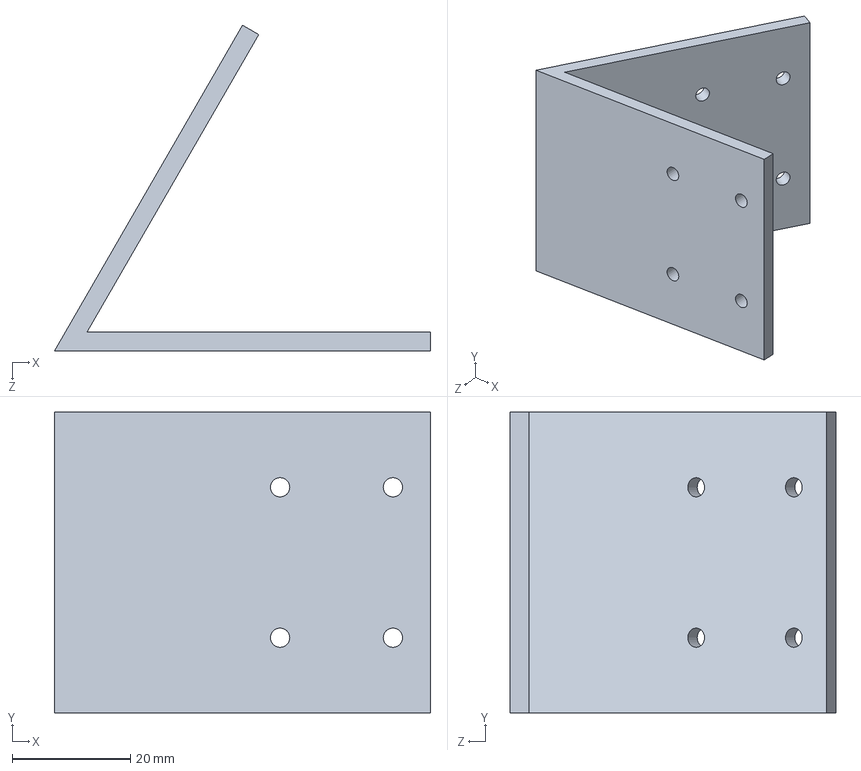
[picture p51: CAD file, 2019-04-22]
projeto da Michigan-U/LinearBookScannerCADW14/Saddle CAD v2/New Saddle CAD/60 Degree Bracket.SLDPRT
63.5 x 50.8 x 55.0 mm
