tonidandel/scanner-linear/projeto da Michigan-U/LinearBookScannerCADW14/Saddle CAD v2/New Saddle CAD/Top Bracket.SLDPRT

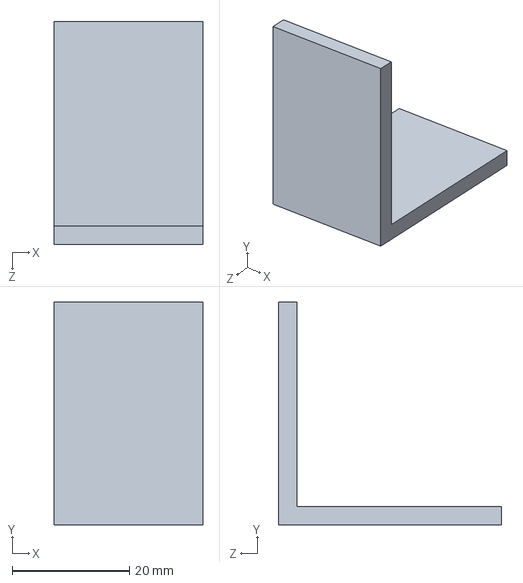
[picture p52: CAD file, 2019-04-22]
projeto da Michigan-U/LinearBookScannerCADW14/Saddle CAD v2/New Saddle CAD/Top Bracket.SLDPRT
25.4 x 38.1 x 38.1 mm
