tonidandel/scanner-linear/projeto da Michigan-U/LinearBookScannerCADW14/Saddle CAD v2/New Saddle CAD/X Paddle Right 60.SLDPRT

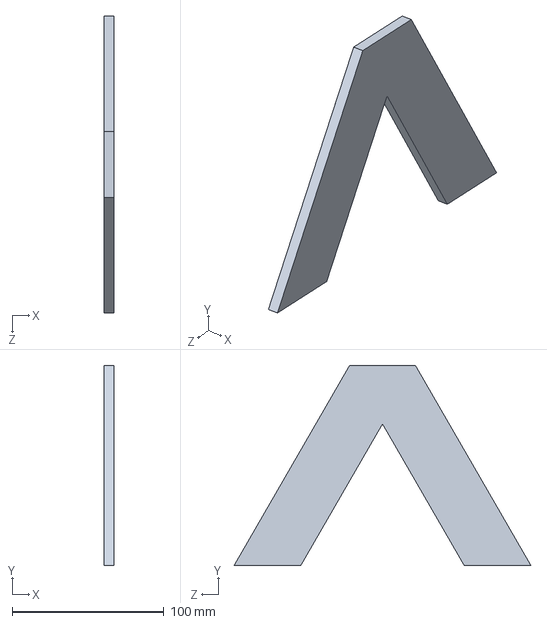
[picture p53: CAD file, 2019-04-22]
projeto da Michigan-U/LinearBookScannerCADW14/Saddle CAD v2/New Saddle CAD/X Paddle Right 60.SLDPRT
6.35 x 132.0 x 195.8 mm
