tonidandel/scanner-linear/projeto da Michigan-U/LinearBookScannerCADW14/Saddle CAD v2/New Saddle CAD/Cross Bar Back.SLDPRT

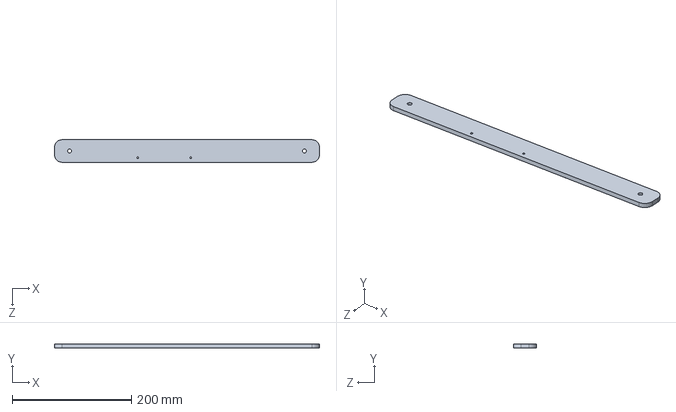
[picture p54: CAD file, 2019-04-22]
projeto da Michigan-U/LinearBookScannerCADW14/Saddle CAD v2/New Saddle CAD/Cross Bar Back.SLDPRT
444.5 x 6.35 x 38.1 mm
