tonidandel/scanner-linear/projeto da Michigan-U/LinearBookScannerCADW14/Saddle CAD v2/New Saddle CAD/Tall X Paddle Bracket.SLDPRT

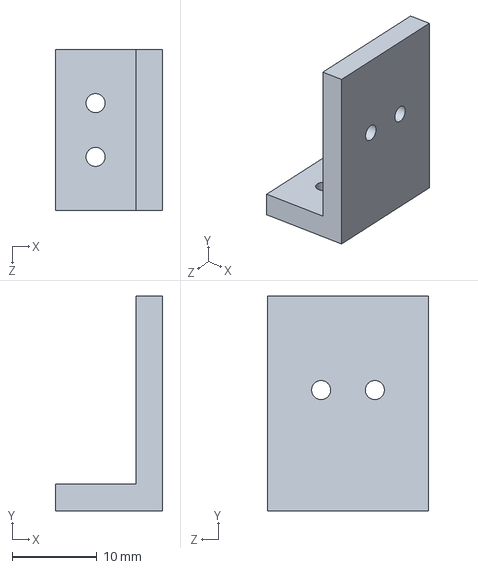
[picture p55: CAD file, 2019-04-22]
projeto da Michigan-U/LinearBookScannerCADW14/Saddle CAD v2/New Saddle CAD/Tall X Paddle Bracket.SLDPRT
12.7 x 25.4 x 19.1 mm
