tonidandel/scanner-linear/(list of files, cad)

Other CAD files:
projeto da Michigan-U/LinearBookScannerCADW14/Motor/Motor Assembly v1/New Driven Pulley.stp
projeto da Michigan-U/LinearBookScannerCADW14/Saddle CAD v2/New Saddle CAD/X Paddle Left Attachment.SLDPRT
projeto da Michigan-U/LinearBookScannerCADW14/Main Body/New Driven Pulley.SLDPRT
projeto da Michigan-U/LinearBookScannerCADW14/Saddle CAD v2/New Saddle CAD/Side Intake.SLDPRT
projeto da Michigan-U/LinearBookScannerCADW14/Saddle CAD v2/New Saddle CAD/Standard Bracket.SLDPRT
projeto da Michigan-U/LinearBookScannerCADW14/Saddle CAD v2/New Saddle CAD/Cross Bar.SLDPRT
Projeto-inicial/linear-book-scanner.skp
projeto da Michigan-U/LinearBookScannerCADW14/Main Body/Base.SLDDRW
projeto da Michigan-U/LinearBookScannerCADW14/Main Body/Brace.SLDDRW
projeto da Michigan-U/LinearBookScannerCADW14/Main Body/Brace.SLDPRT
projeto da Michigan-U/LinearBookScannerCADW14/Main Body/Wall_1a.SLDDRW
projeto da Michigan-U/LinearBookScannerCADW14/Saddle CAD v2/New Saddle CAD/59625K330 (1).SLDPRT
projeto da Michigan-U/LinearBookScannerCADW14/Saddle CAD v2/New Saddle CAD/91500A126.SLDPRT
projeto da Michigan-U/LinearBookScannerCADW14/Saddle CAD v2/New Saddle CAD/91500A128.SLDPRT
projeto da Michigan-U/LinearBookScannerCADW14/Saddle CAD v2/New Saddle CAD/92210A546.SLDPRT
projeto da Michigan-U/LinearBookScannerCADW14/Saddle CAD v2/New Saddle CAD/Follower Spacer.SLDDRW
projeto da Michigan-U/LinearBookScannerCADW14/Saddle CAD v2/New Saddle CAD/Tall X Paddle Bracket.SLDDRW
projeto da Michigan-U/LinearBookScannerCADW14/Saddle CAD v2/New Saddle CAD/X Paddle Bracket.SLDDRW
projeto da Michigan-U/LinearBookScannerCADW14/Vacuum/Elbow.SLDDRW
projeto da Michigan-U/LinearBookScannerCADW14/Vacuum/Inside Vacuum Tube.SLDDRW
projeto da Michigan-U/LinearBookScannerCADW14/Vacuum/Outside Vacuum Tube.SLDDRW
