tonidandel/scanner-linear/projeto da Michigan-U/Engineering Drawings/Saddle/Cross Bar Back.PDF

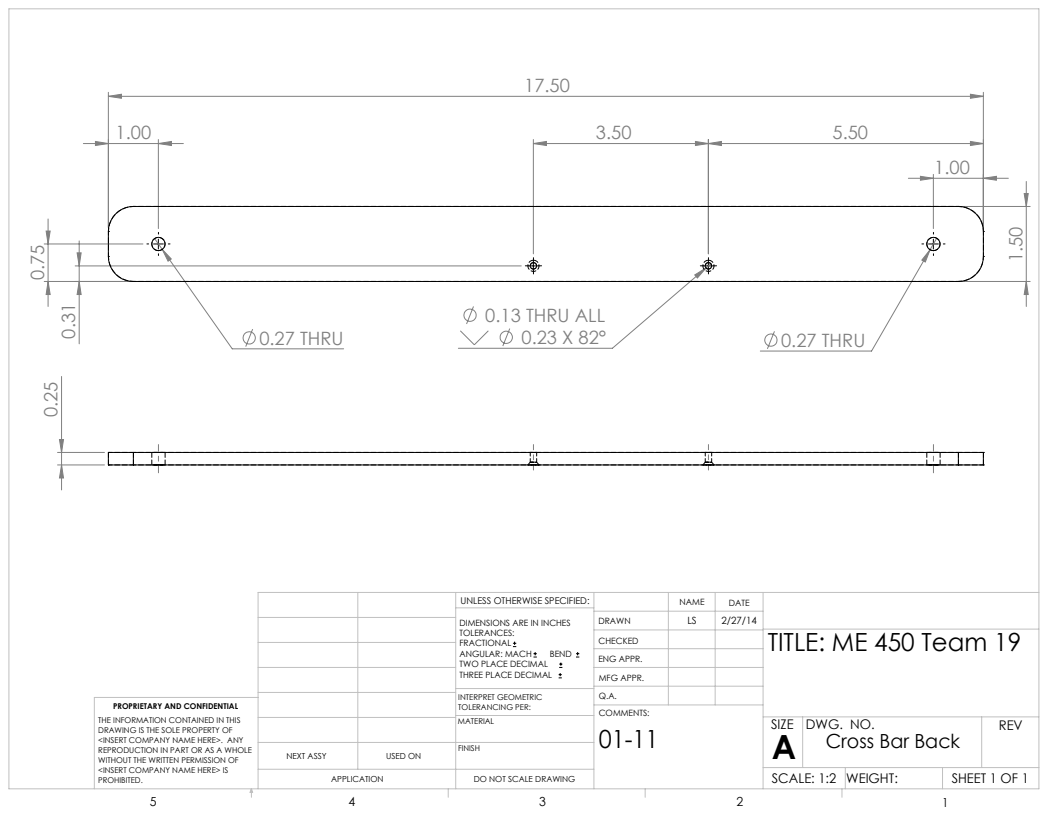
[picture p57: page 1]
0.13 THRU ALL; 0.27 THRU; Cross Bar Back; SHEET 1 OF 1; SCALE: 1:2 WEIGHT:; DWG. NO.; REV; MFG APPR.; ENG APPR.; INTERPRET GEOMETRIC TOLERANCING PER:; ANGULAR: MACH; BEND; NEXT ASSY; USED ON

UNLESS OTHERWISE SPECIFIED:

TITLE: ME 450 Team 19

DIMENSIONS ARE IN INCHES
TOLERANCES:
FRACTIONAL
TWO PLACE DECIMAL
THREE PLACE DECIMAL

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

DO NOT SCALE DRAWING
