tonidandel/scanner-linear/(commit log)

2019-04-22 arquivos do projeto do scanner linear
    [linear-book-scanner.skp]
2019-04-22 atualizacao - projeto da Michigan-U adicionado
    [linear-book-scanner.skp]
2019-04-22 atualizacao 3.0
    [59625K330 (1).SLDPRT, 60 Degree Bracket.SLDPRT, 60degBracket.SLDPRT, 90degBracket.SLDPRT, 91500A126.SLDPRT, 91500A128.SLDPRT, 92210A546.SLDPRT, Base.SLDDRW]
